fredriknk/ssense-lte/CAD/ssense-lte/ssense-lte.kicad_pcb

## KiCad design CAD/ssense-lte/ssense-lte.kicad_pcb (2025-08-19)

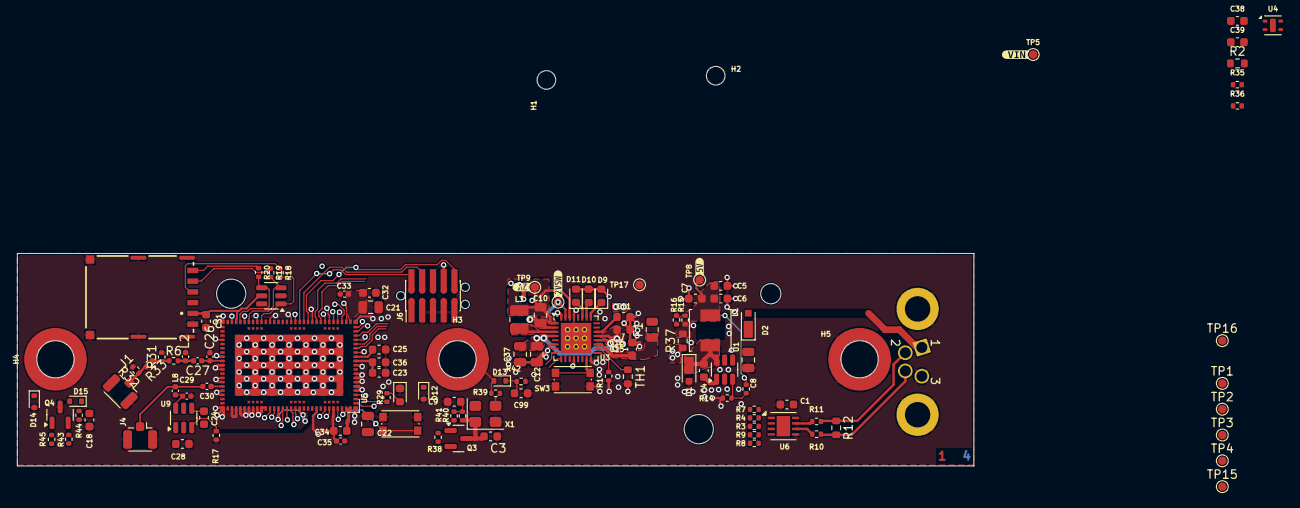
[picture p2: board ssense-lte.kicad_pcb from above]

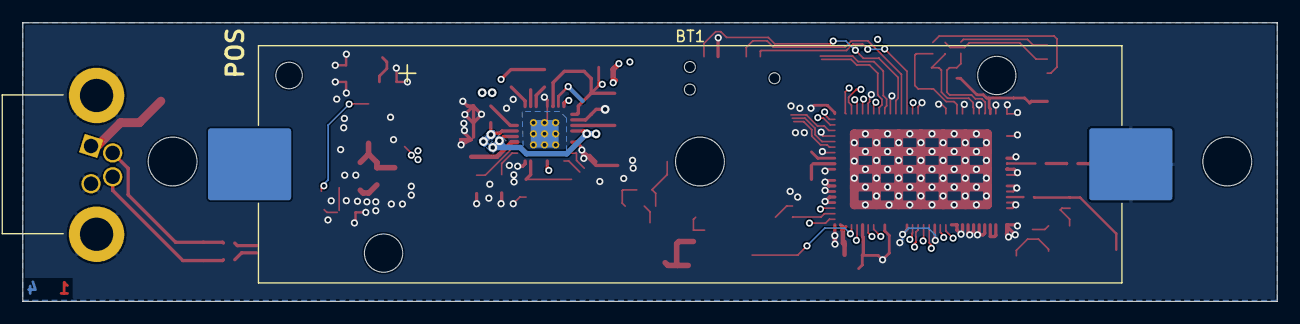
[picture p3: board ssense-lte.kicad_pcb from below]

Board: 4 copper layers, 113.0 x 25.1 mm, 123 parts (3 on the bottom side), 68 nets.

Parts:
BT1: Keystone 1042; BatteryHolder_Keystone_1042_1x18650
C1, C4, C32, C34, C36, C38: 0.1uF; C_0603_1608Metric
C3: 100nF; C_0603_1608Metric
C5, C6, C7, C15, C23, C25: 4.7uF; C_0603_1608Metric
C8: 2.2uF; C_0805_2012Metric
C9, C18, C24, C99: 1nF; C_0603_1608Metric
C10, C12, C37: 10uF; C_0805_2012Metric
C11, C16, C28, C31, C39: 1uF; C_0603_1608Metric
C21, C22: 47uF; C_0805_2012Metric
C26, C27, C33, C35: 15pF; C_0402_1005Metric_Sqr
C29, C30: 56pF; C_0402_1005Metric_Sqr
D1, D2: MSS1P3L-M3/89A; D_MicroSMP_AK
D7: LG L29K-G2J1-24-Z; LED_0603_1608Metric
D9, D10, D11: LED; LED_0603_1608Metric
D12, D14: Zener Prot 5V; D_SOD-523
D13, D15: CDSU101A; D_SOD-523
F1: 0805L110WR; Fuse_0805_2012Metric
H1, H2: MountingHole; MountingHole_2.2mm_M2
H3, H4, H5: 9774025360R; Mounting_Wuerth_WA-SMSI-M3_H2.5mm_9774025360
J1, J4: HIROSE ELECTRIC U.FL-R-SMT-1; U.FL_Hirose_U.FL-R-SMT-1_Vertical
J2: IEC61076-2_M8_A-coding_01x04_Receptacle_Shielded; STEWART_SS-12800-004_M8_04_Socket_Right_Angle
J3: 693043020611
J6: JLINK; SEXY_pinpogo
L1: 22uH; L_Abracon_AMDLA4020S
L2: 39NH; C_0402_1005Metric_Sqr
L3: 2.2uH; L_1008_2520Metric
L8: 68 nH; C_0402_1005Metric_Sqr
Q3: IRLML6401; SOT-23
Q4: MMBT3906; SOT-23
R1: 68k; R_0402_1005Metric
R2: 470R; R_0603_1608Metric
R3, R4, R14, R16, R35, R36, R38, R39, R40, R41, R43, R45: 10k; R_0402_1005Metric
R6, R7, R8, R9, R10, R11, R31, R32, R33: 0R; R_0402_1005Metric
R12: 120R; R_0603_1608Metric
R13: 56k; R_0402_1005Metric
R15: 15k; R_0402_1005Metric
R17, R42, R44: 1M; R_0402_1005Metric
R18, R19, R20: 100R; R_0402_1005Metric
R29: 150R; R_0402_1005Metric
R37: 0R; R_0603_1608Metric
SW1, SW3: KMR223NGLFG; SW_Push_1P1T_NO_CK_KMR2
TH1: 10k NTC; R_0603_1608Metric
TP1: SWDIO; TestPoint_Pad_D1.0mm
TP2: SWDCLK; TestPoint_Pad_D1.0mm
TP3: SWO; TestPoint_Pad_D1.0mm
TP4: RST; TestPoint_Pad_D1.0mm
TP5: VIN; TestPoint_Pad_D1.0mm
TP8: 5V; TestPoint_Pad_D1.0mm
TP9: 2V; TestPoint_Pad_D1.0mm
TP10: I1; TestPoint_Pad_D1.0mm
TP15, TP16, TP17: GND; TestPoint_Pad_D1.0mm
U1: LV2862XDDC; SOT-23-6
U3: nPM1300-QEXX; QFN-32-1EP_5x5mm_P0.5mm_EP3.6x3.6mm_ThermalVias
U4: SHTC3; Sensirion_DFN-4-1EP_2x2mm_P1mm_EP0.7x1.6mm
U5: nRF9160-SICA; LGA_9160_16.0x10.5mm
U6: THVD1450DR; VSON-8-1EP_3x3mm_P0.65mm_EP1.6x2.4mm
U8: USBLC6-4SC6; SOT-23-6
U9: TPS22917DBV; SOT-23-6
X1: KC3225K75.0000C1GE00; Oscillator_SMD_SeikoEpson_SG8002CE-4Pin_3.2x2.5mm
kibuzzard-680B6FC7: G***; kibuzzard-680B6FC7
kibuzzard-680B701D: G***; kibuzzard-680B701D
kibuzzard-680B714A: G***; kibuzzard-680B714A
kibuzzard-680B715D: G***; kibuzzard-680B715D
kibuzzard-689F1011: G***; kibuzzard-689F1011

Connections:
+1V8SIM: C31.1, J3.C1 (VCC), U5.49 (SIM_1V8), U8.5 (VBUS)
+3V3: C10.1, C23.1, C36.1, C38.1, C39.1, J6.1, L3.1, R35.2, R36.1, TP9.1, U3.1 (VOUT1), U3.12 (VDDIO), U3.30 (LSIN2/VINLDO2), U4.1 (VDD), U5.12 (VDD_GPIO)
+3V3SW: C1.1, TP10.1, U3.31 (LSOUT2/VOUTLDO2), U6.8 (VCC)
+3V6: Q3.2 (S), R38.1
+5V: C11.1, U3.22 (VBUSOUT)
+5VL: C16.1, R37.1, U3.21 (VBUS)
+12V: C8.1, D2.1 (K), U1.5 (VIN)
+BATT: C15.1, F1.1, U3.19 (VBAT)
/POWER/A': R10.1, U6.6 (A)
/POWER/A_P: J2.2, R11.2, R12.1
/POWER/B': R11.1, U6.7 (B)
/POWER/B_N: J2.4, R10.2, R12.2
/POWER/FB: R13.2, R14.1, U1.3 (FB)
/POWER/RE/DE': R3.2, R9.2, U6.2 (~RE), U6.3 (DE)
/POWER/RXD': R7.2, U6.1 (RO)
/POWER/SW: C4.2, D1.1 (K), L1.1, U1.6 (SW)
/POWER/SW1: L3.2, U3.3 (SW1)
/POWER/SW5V: C5.1, C6.1, C7.1, L1.2, R13.1, R15.1, R37.2, TP8.1
/POWER/TXD': R4.1, R8.2, U6.4 (DI)
/POWER/VIN: D2.2 (A), J2.1, TP5.1
/nrf9160/ANT: C26.1, C27.1, U5.61 (ANT)
/nrf9160/GPS_: C30.2, J4.1 (In), L8.1
COEX0: R17.2, U5.93 (COEX0), U9.3 (ON)
GND: BT1.2 (-), C1.2, C3.2, C5.2, C6.2, C7.2, C8.2, C9.2, C10.2, C11.2, C12.2, C15.2, C16.2, C18.2, C21.2, C22.2, C23.2, C25.2, C26.2, C28.2, C29.2, C31.2, C32.2, C33.2, C34.2, C35.2, C36.2, C37.2, C38.2, C39.2, C99.2, D1.2 (A), D7.1 (K), D12.2 (A), D14.2 (A), H5.1, J1.2 (Ext), J2.3, J2.SH, J3.C5 (GND), J3.S1, J3.S2, J3.S3, J3.S4, J3.S5, J3.S6, J4.2 (Ext), J6.3, J6.5, J6.7, J6.8, J6.9, L2.2, Q4.3 (C), R1.2, R2.2, R3.1, R14.2, R16.2, R17.1, R31.2, R32.2, R41.1, R42.2, R44.2, SW1.2, SW3.2, TH1.1, TP15.1, TP16.1, TP17.1, U1.2 (GND), U3.2 (PVSS1), U3.6 (PVSS2), U3.16 (VSET2), U3.29 (LSOUT1/VOUTLDO1), U3.33 (AVSS), U4.4 (VSS), U5.1 (GND_Shield), U5.5 (GND_Shield), U5.6 (GND_Shield), U5.7 (GND_Shield), U5.8 (GND_Shield), U5.9 (GND_Shield), U5.11 (GND_Shield), U5.14 (GND_Shield), U5.17 (GND_Shield), U5.21 (GND_Shield), U5.27 (GND_Shield), U5.31 (GND_Shield), U5.36 (GND_Shield), U5.41 (GND_Shield), U5.44 (GND_Shield), U5.47 (GND_Shield), U5.50 (GND_Shield), U5.52 (GND_Shield), U5.56 (GND_Shield), U5.60 (GND_Shield), U5.62 (GND_Shield), U5.63 (GND_Shield), U5.65 (GND_Shield), U5.66 (GND_Shield), U5.68 (GND_Shield), U5.69 (GND_Shield), U5.72 (GND_Shield), U5.74 (GND_Shield), U5.75 (GND_Shield), U5.76 (GND_Shield), U5.77 (GND_Shield), U5.78 (GND_Shield), U5.79 (GND_Shield), U5.80 (GND_Shield), U5.81 (GND_Shield), U5.82 (GND_Shield), U5.85 (GND_Shield), U5.90 (GND_Shield), U5.94 (GND_Shield), U5.98 (GND_Shield), U5.103 (VSS), U6.5 (GND), U8.2 (GND), U9.2 (GND), X1.2 (GND)
HF_OSC: Q3.1 (G), R38.2
unnamed: BT1.1 (+), F1.2
unnamed: C27.2, L2.1, R6.2
unnamed: D7.2 (A), R29.1
unnamed: D9.1 (K), U3.25 (LED0)
unnamed: D10.1 (K), U3.26 (LED1)
unnamed: D11.1 (K), U3.27 (LED2)
unnamed: D12.1 (K), D13.2 (A), H3.1, R39.2
unnamed: D14.1 (K), D15.2 (A), H4.1, Q4.2 (E), R43.2
unnamed: J1.1 (In), R32.1, R33.2
unnamed: J3.C3 (CLK), R19.1
unnamed: J3.C7 (I/O), R20.1
unnamed: J3.C2 (RST), R18.1
unnamed: C3.1, Q3.3 (D), R40.2, X1.1 (EN), X1.4 (Vdd)
unnamed: Q4.1 (B), R45.1
unnamed: R6.1, R31.1, R33.1
unnamed: C4.1, U1.1 (CB)
unnamed: TH1.2, U3.18 (NTC)
unnamed: SW3.1, U3.15 (SHPHLD)
unnamed: R1.1, U3.17 (VSET1)
unnamed: C25.1, U5.13 (DEC0)
unnamed: C30.1, U5.67 (GPS)
unnamed: C24.2, U9.4 (CT)
unnamed: C29.1, L8.2, U9.6 (VOUT)
unnamed: R39.1, X1.3 (OUT)
P0.04: SW1.1, U5.100 (P0.04)
P0.05: R15.2, R16.1, U5.2 (P0.05)
P0.06: R29.2, U5.3 (P0.06)
P0.11: U3.8 (GPIO1), U5.19 (P0.11)
P0.12: U3.9 (GPIO2), U5.20 (P0.12)
P0.28: R35.1, U3.13 (SDA), U4.3 (SDA), U5.86 (P0.28)
P0.29: R36.2, U3.14 (SCL), U4.2 (SCL), U5.87 (P0.29)
PWM: R43.1, R45.2
SENS_OUT: C18.1, D15.1 (K), R44.1
SENS_OUT_HF: C99.1, D13.1 (K), R42.1
SENS_OUT_HF_REF: C9.1, R40.1, R41.2
SIM_CLK: R19.2, U5.46 (SIM_CLK), U8.3 (I/O2)
SIM_IO: R20.2, U5.48 (SIM_IO), U8.4 (I/O3)
SIM_RST: R18.2, U5.43 (SIM_RST), U8.1 (I/O1)
SWDCLK: J6.4, TP2.1, U5.33 (SWDCLK)
SWDIO: J6.2, TP1.1, U5.34 (SWDIO)
SWO: J6.6, TP3.1, U5.95 (P0.00)
VCC: C12.1, C21.1, C22.1, C24.1, C28.1, C32.1, C33.1, C34.1, C35.1, C37.1, D9.2 (A), D10.2 (A), D11.2 (A), U3.4 (PVDD), U3.20 (VSYS), U3.32 (VOUT2), U5.22 (VDD2), U5.101 (ENABLE), U5.102 (VDD1), U9.1 (VIN)
~RESET: J6.10, TP4.1, U5.32 (~RESET)
