fredriknk/ssense-lte/(commit log)

2025-08-15 Feat: First push
    [bom.csv, designators.csv, positions.csv]
2025-08-19 Backup commit
    [ENV_SENSOR.kicad_sch, GAS_SENSOR.kicad_sch, POWER.kicad_sch, nrf9160.kicad_sch, ssense-lte.kicad_pcb]
